alanpreed/OpenWindow/README.md

# OpenWindow
OpenWindow is a project that aims to create an open-source electric window controller for my car.
