alanpreed/OpenWindow/CAD/output/current_pcb_clamp.stl

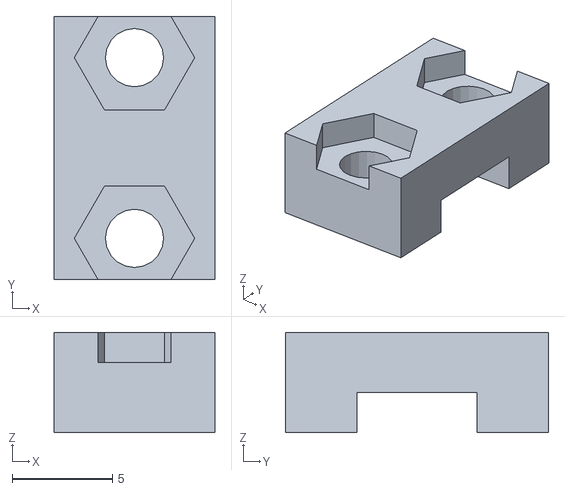
[picture p1: CAD file, 2021-03-17]
CAD/output/current_pcb_clamp.stl
8.00 x 13.1 x 5.00
