alanpreed/OpenWindow/CAD/output/case.stl

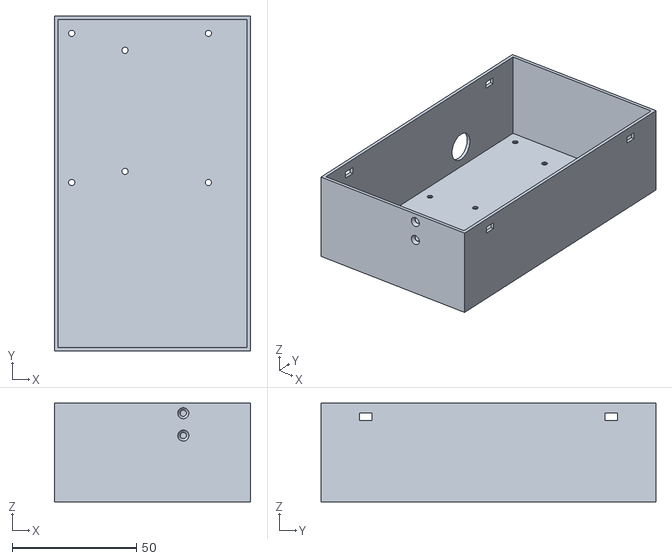
[picture p2: CAD file, 2021-03-17]
CAD/output/case.stl
79.0 x 134.8 x 39.7
