alanpreed/OpenWindow/CAD/output/current_pcb_spacer.stl

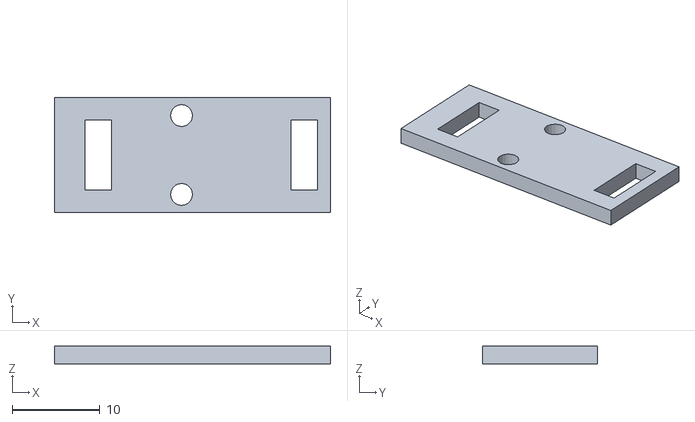
[picture p3: CAD file, 2021-03-17]
CAD/output/current_pcb_spacer.stl
31.5 x 13.1 x 2.00
