alanpreed/OpenWindow/CAD/output/case_lid.stl

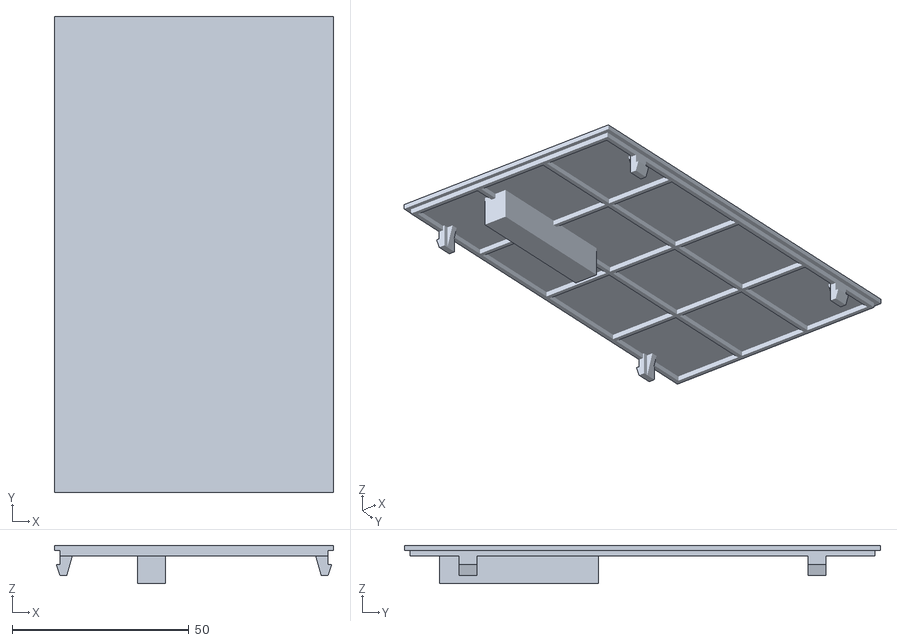
[picture p4: CAD file, 2021-03-17]
CAD/output/case_lid.stl
79.0 x 134.8 x 10.9
