alanpreed/OpenWindow/Electronics/OpenWindow_PCB/output/OpenWindow_PCB_schematic.pdf

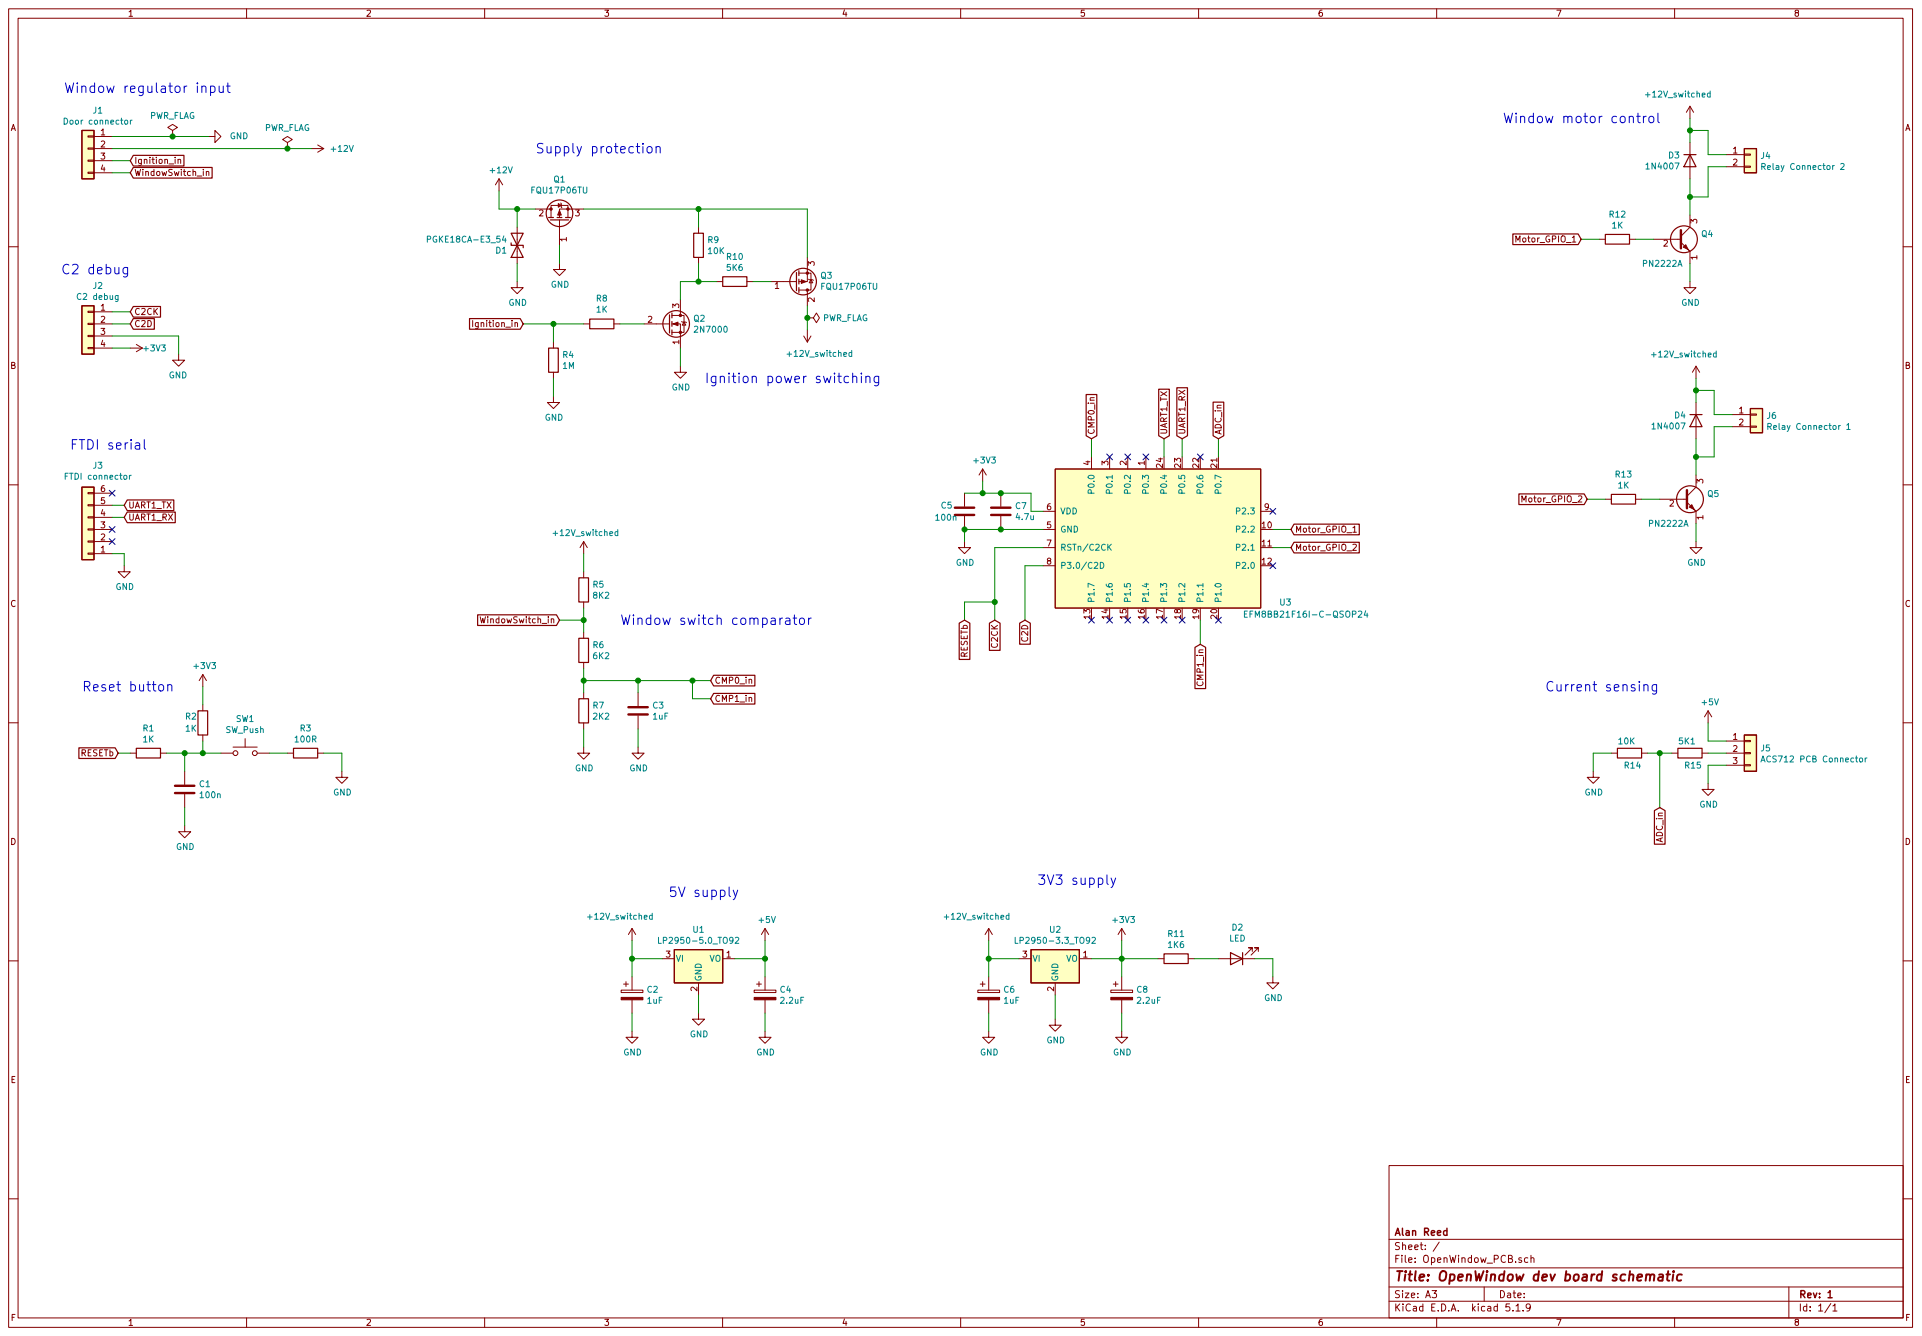
[picture p5: page 1]

File: OpenWindow_PCB.sch Sheet: / Alan Reed

Id: 1/1 Title: OpenWindow dev board schematic
