alanpreed/OpenWindow/Electronics/OpenWindow_PCB/OpenWindow_PCB.kicad_pcb

## KiCad design Electronics/OpenWindow_PCB/OpenWindow_PCB.kicad_pcb (2021-03-21)

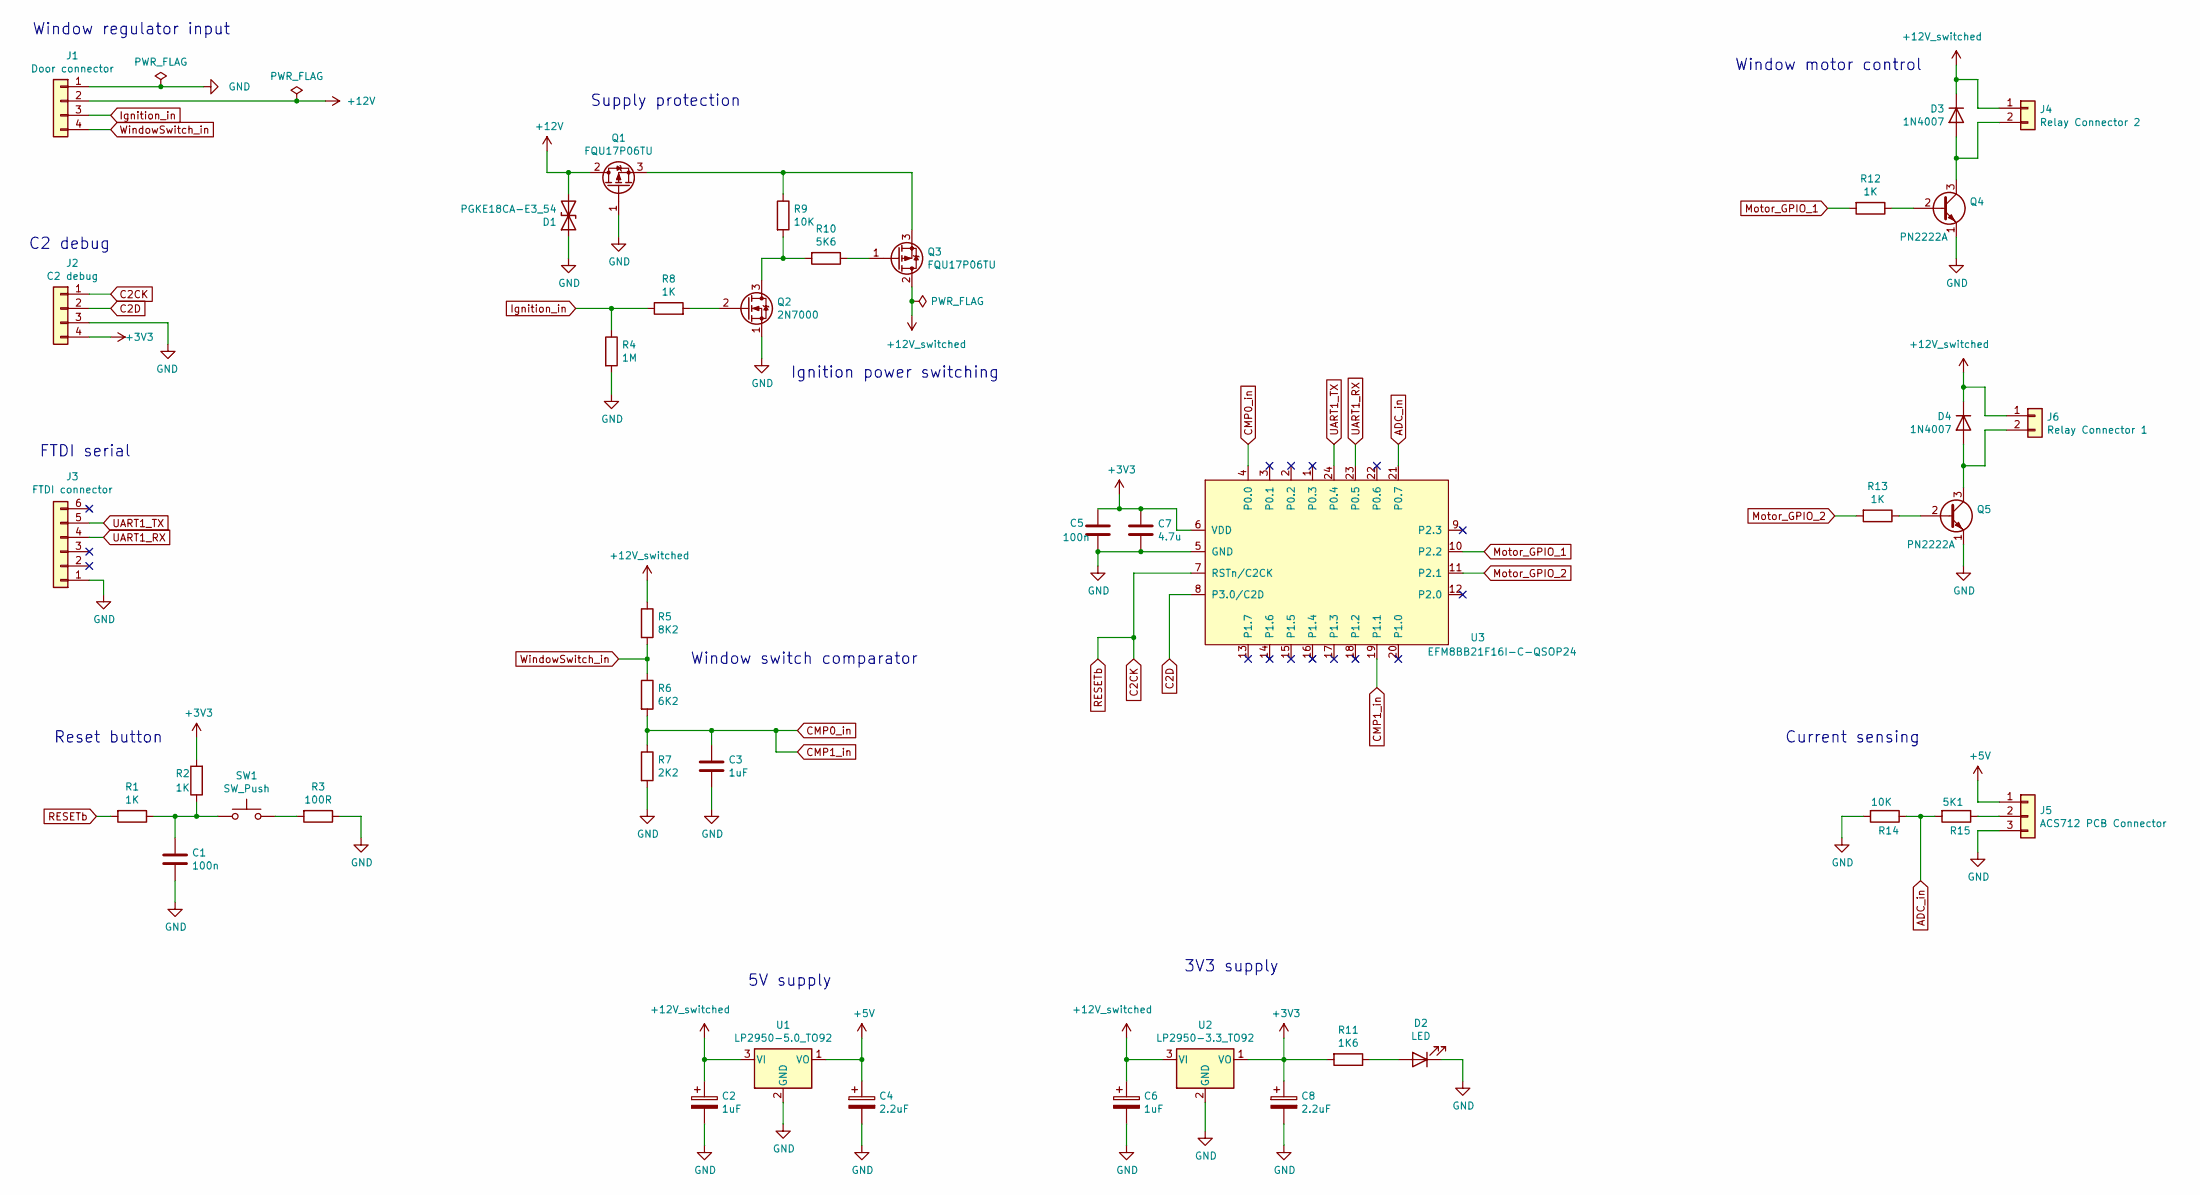
[picture p6: schematic OpenWindow_PCB.sch, OpenWindow dev board schematic]

Parts:
C1, C5: 100n; C_0805_2012Metric_Pad1.18x1.45mm_HandSolder
C2, C3, C6: 1uF; CP_Radial_D5.0mm_P2.00mm
C4, C8: 2.2uF; CP_Radial_D5.0mm_P2.00mm
C7: 4.7u; C_0805_2012Metric_Pad1.18x1.45mm_HandSolder
D1: PGKE18CA-E3_54; D_DO-15_P12.70mm_Horizontal
D2: LED; LED_D3.0mm
D3, D4: 1N4007; D_DO-41_SOD81_P10.16mm_Horizontal
J1: Door connector; JST_XH_B4B-XH-AM_1x04_P2.50mm_Vertical
J2: C2 debug; PinHeader_1x04_P2.54mm_Vertical
J3: FTDI connector; PinHeader_1x06_P2.54mm_Vertical
J4: Relay Connector 2; TerminalBlock_Phoenix_MKDS-3-2-5.08_1x02_P5.08mm_Horizontal
J5: ACS712 PCB Connector; JST_XH_B3B-XH-A_1x03_P2.50mm_Vertical
J6: Relay Connector 1; TerminalBlock_Phoenix_MKDS-3-2-5.08_1x02_P5.08mm_Horizontal
Q1, Q3: FQU17P06TU; TO-251-3_Vertical
Q2: 2N7000; TO-92_Inline
Q4, Q5: PN2222A; TO-92_Inline
R1, R2: 1K; R_0603_1608Metric_Pad0.98x0.95mm_HandSolder
R3: 100R; R_0603_1608Metric_Pad0.98x0.95mm_HandSolder
R4: 1M; R_Axial_DIN0411_L9.9mm_D3.6mm_P12.70mm_Horizontal
R5: 8K2; R_Axial_DIN0411_L9.9mm_D3.6mm_P12.70mm_Horizontal
R6: 6K2; R_Axial_DIN0411_L9.9mm_D3.6mm_P12.70mm_Horizontal
R7: 2K2; R_Axial_DIN0411_L9.9mm_D3.6mm_P12.70mm_Horizontal
R8, R12, R13: 1K; R_Axial_DIN0411_L9.9mm_D3.6mm_P12.70mm_Horizontal
R9, R14: 10K; R_Axial_DIN0411_L9.9mm_D3.6mm_P12.70mm_Horizontal
R10: 5K6; R_Axial_DIN0411_L9.9mm_D3.6mm_P12.70mm_Horizontal
R11: 1K6; R_Axial_DIN0411_L9.9mm_D3.6mm_P12.70mm_Horizontal
R15: 5K1; R_Axial_DIN0411_L9.9mm_D3.6mm_P12.70mm_Horizontal
SW1: SW_Push; SW_PUSH_6mm
U1: LP2950-5.0_TO92; TO-92_Inline
U2: LP2950-3.3_TO92; TO-92_Inline
U3: EFM8BB21F16I-C-QSOP24; QSOP-24_3.9x8.7mm_P0.635mm

Connections:
+3V3: C5.1, C7.1, C8.1, J2.4, R2.2, R11.2, U2.1 (VO), U3.6 (VDD)
+5V: C4.1, J5.1, U1.1 (VO)
+12V: D1.2 (A2), J1.2, Q1.2 (D)
+12V_switched: C2.1, C6.1, D3.1 (K), D4.1 (K), J4.1, J6.1, Q3.2 (D), R5.1, U1.3 (VI), U2.3 (VI)
ADC_in: R14.1, R15.2, U3.21 (P0.7)
C2CK: J2.1, R1.2, U3.7 (RSTn/C2CK)
C2D: J2.2, U3.8 (P3.0/C2D)
CMP0_in: C3.1, R6.2, R7.1, U3.4 (P0.0), U3.19 (P1.1)
GND: C1.2, C2.2, C3.2, C4.2, C5.2, C6.2, C7.2, C8.2, D1.1 (A1), D2.1 (K), J1.1, J2.3, J3.1, J5.3, Q1.1 (G), Q2.1 (S), Q4.1 (E), Q5.1 (E), R3.1, R4.2, R7.2, R14.2, U1.2 (GND), U2.2 (GND), U3.5 (GND)
Ignition_in: J1.3, R4.1, R8.1
Motor_GPIO_1: R12.2, U3.10 (P2.2)
Motor_GPIO_2: R13.2, U3.11 (P2.1)
unnamed: C1.1, R1.1, R2.1, SW1.1
unnamed: D2.2 (A), R11.1
unnamed: D3.2 (A), J4.2, Q4.3 (C)
unnamed: D4.2 (A), J6.2, Q5.3 (C)
unnamed: J5.2, R15.1
unnamed: Q1.3 (S), Q3.3 (S), R9.1
unnamed: Q2.2 (G), R8.2
unnamed: Q2.3 (D), R9.2, R10.2
unnamed: Q3.1 (G), R10.1
unnamed: Q4.2 (B), R12.1
unnamed: Q5.2 (B), R13.1
unnamed: R3.2, SW1.2
UART1_RX: J3.4, U3.23 (P0.5)
UART1_TX: J3.5, U3.24 (P0.4)
WindowSwitch_in: J1.4, R5.2, R6.1

Notes on the sheet:
Supply protection
Ignition power switching
5V supply
Window motor control
Window regulator input
FTDI serial
C2 debug
Window switch comparator
Current sensing
Reset button
3V3 supply

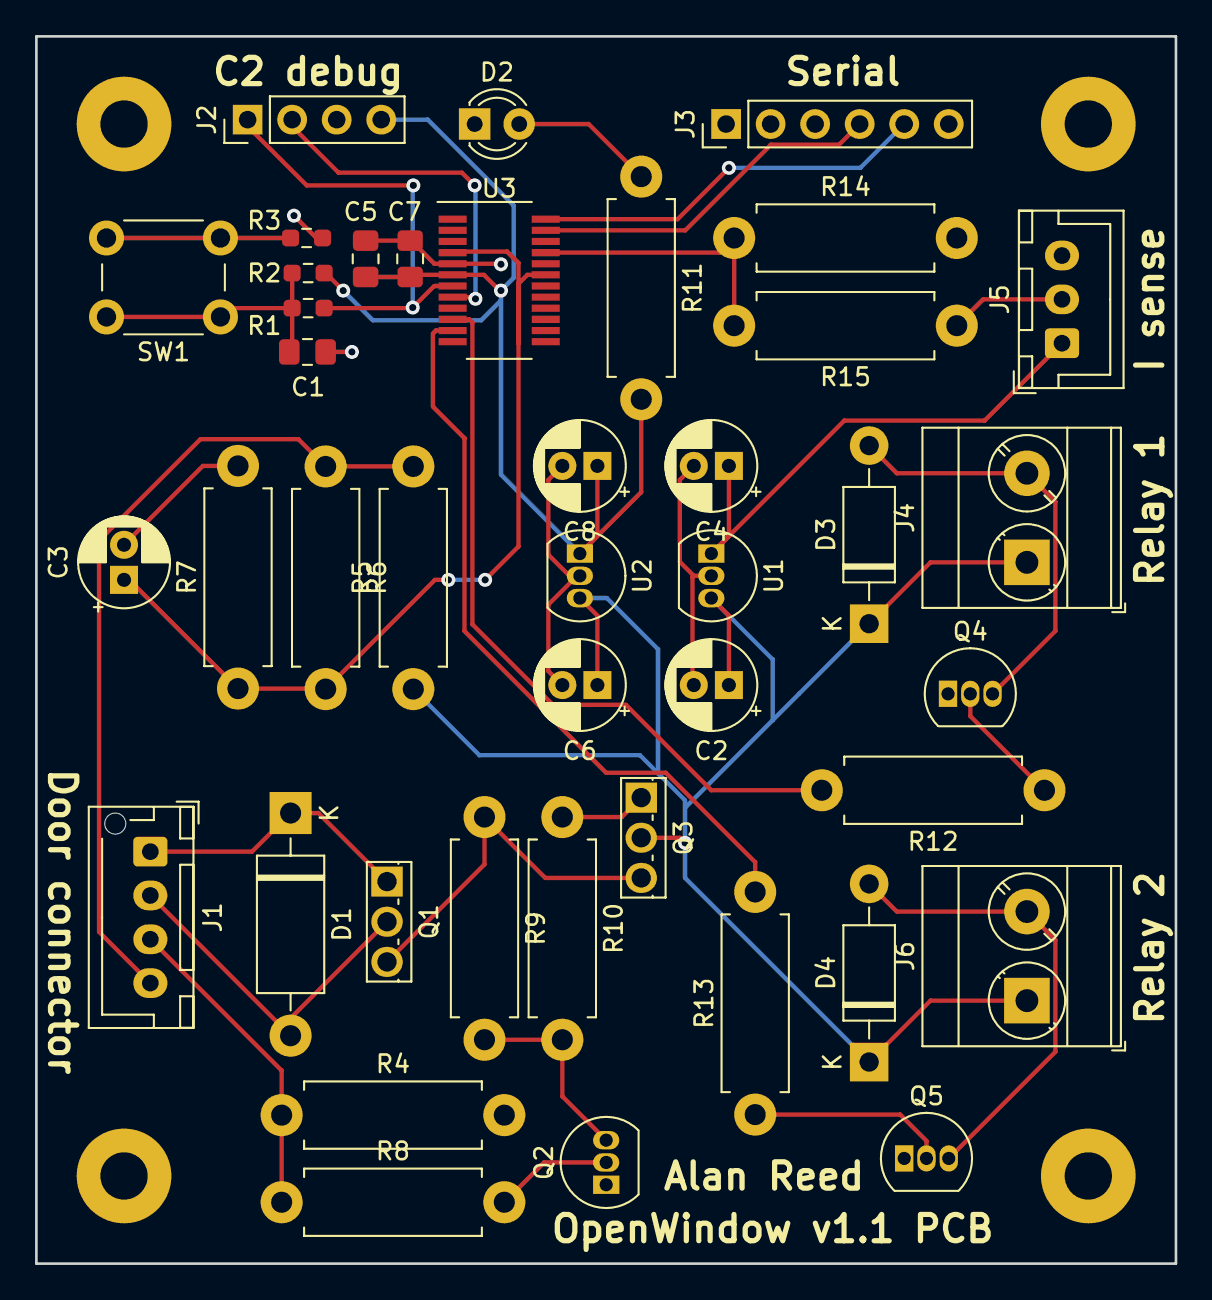
[picture p7: board OpenWindow_PCB.kicad_pcb from above]

Board: 2 copper layers, 65.0 x 70.0 mm, 42 parts (0 on the bottom side), 27 nets.
