alanpreed/OpenWindow/Software/EFM8OpenWindow/inc/motor.h

/*
 * motor.h
 *
 *  Created on: 7 Oct 2020
 *      Author: alan
 */

#ifndef INC_MOTOR_H_
#define INC_MOTOR_H_

void motor_start_raising(void);

void motor_start_lowering(void);

void motor_stop(void);

#endif /* INC_MOTOR_H_ */
