alanpreed/OpenWindow/Software/EFM8OpenWindow/inc/safe_print.h

/*
 * debug.h
 *
 *  Created on: 5 Oct 2020
 *      Author: alan
 */

#ifndef INC_SAFE_PRINT_H_
#define INC_SAFE_PRINT_H_

void safe_printf( const char* format, ... ) reentrant;

#endif /* INC_SAFE_PRINT_H_ */
