alanpreed/OpenWindow/Software/EFM8OpenWindow/src/safe_print.c

/*
 * safe_print.c
 *
 *  Created on: 5 Oct 2020
 *      Author: alan
 */

#include <stdio.h>
#include <stdarg.h>
#include <stdint.h>
#include <SI_EFM8BB2_Register_Enums.h>

// Reference for how to wrap printf:
// https://www.ozzu.com/cpp-tutorials/tutorial-writing-custom-printf-wrapper-function-t89166.html

void safe_printf( const char* format, ... ) reentrant {
  uint8_t interrupt_status;
  va_list args;

  interrupt_status = IE_EA;
  IE_EA = 0;
  va_start( args, format );
  vprintf(format, args );
  va_end( args );
  IE_EA = interrupt_status;
}
