alanpreed/OpenWindow/Software/EFM8OpenWindow/inc/UART1.h

/*
 * UART1.h
 *
 *  Created on: 29 Sep 2020
 *      Author: alan
 */

#ifndef INC_UART1_H_
#define INC_UART1_H_

void UART1_init(void);

void UART1_tx_callback(void);

void UART1_rx_callback(void);

#endif /* INC_UART1_H_ */
