alanpreed/OpenWindow/(commit log)

2020-09-29 Updated hardware configuration to enable UART1
2020-09-29 Initial attempt at interrupt-driven UART driver
2020-09-29 Simplified so that TX interrupt is always enabled
2020-09-29 Configured and tested pins for relay control
2020-10-05 Created interrupt-safe print function. Added initial ADC functionality
2020-10-06 Added linker control file to prevent interrupt function warnings
2020-10-08 Made print and buffer functions reentrant
2020-10-08 Created motor control
2020-10-08 Split CMP init to prevent interrupts on startup
    [switch.c]
2020-10-09 Changed motor pins, enabled ADC timer trigger
2020-10-09 Completed ADC config and driver
2020-10-11 Created initial schematic
    [OpenWindow.kicad_pcb, OpenWindow.sch]
2020-10-13 Made state machine more tolerant of errors
    [state_machine.c]
2021-01-23 Minor schematic changes
    [OpenWindow.sch]
2021-01-23 Set up Kicad project for PCB design
    [OpenWindow_PCB.kicad_pcb, OpenWindow_PCB.sch, OpenWindow_devboard.kicad_pcb, OpenWindow_devboard.sch]
2021-01-27 Initial PCB layout
    [OpenWindow_PCB.kicad_pcb, OpenWindow_PCB.sch]
2021-03-17 Added PCB layout output files
    [OpenWindow_PCB-B_Cu.gbr, OpenWindow_PCB-B_Mask.gbr, OpenWindow_PCB-B_Paste.gbr, OpenWindow_PCB-B_SilkS.gbr, OpenWindow_PCB-Edge_Cuts.gbr, OpenWindow_PCB-F_Cu.gbr, OpenWindow_PCB-F_Mask.gbr, OpenWindow_PCB-F_Paste.gbr]
2021-03-17 Updated build config for PCB instead of dev board
2021-03-17 Added CAD files for case and current PCB mounts
    [case.scad, case.stl, case_lid.stl, current_pcb_clamp.stl, current_pcb_mounts.scad, current_pcb_spacer.stl]
2021-03-17 Added missing description
    [case.scad, current_pcb_mounts.scad]
2021-03-21 Added basic bill of materials
    [OpenWindow_final_BOM.csv]
2021-03-21 Corrected C2 debug header
    [OpenWindow_PCB-B_Cu.gbr, OpenWindow_PCB-B_Mask.gbr, OpenWindow_PCB-B_Paste.gbr, OpenWindow_PCB-B_SilkS.gbr, OpenWindow_PCB-Edge_Cuts.gbr, OpenWindow_PCB-F_Cu.gbr, OpenWindow_PCB-F_Mask.gbr, OpenWindow_PCB-F_Paste.gbr]
